dalvador2/nixie_clock/pcb/nixie_clock/in-14-nixie-tube-1.snapshot.4/NX-SZP-IN14/Render/Render_white_1.JPG

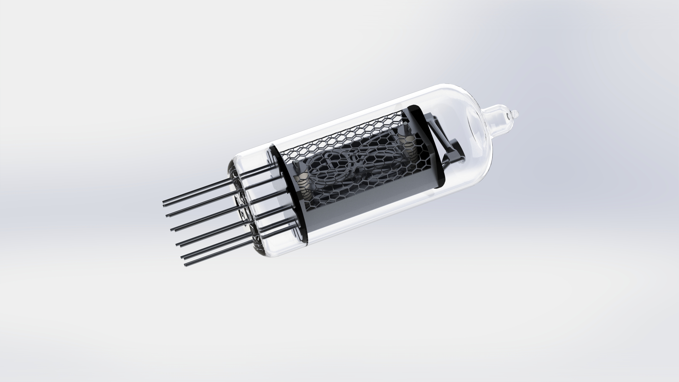
pcb/nixie_clock/in-14-nixie-tube-1.snapshot.4/NX-SZP-IN14/Render/Render_white_1.JPG
