dalvador2/nixie_clock/pcb/nixie_clock/in-14-nixie-tube-1.snapshot.4/NX-SZP-IN14/NX-SZP-IN14-v01.SLDASM

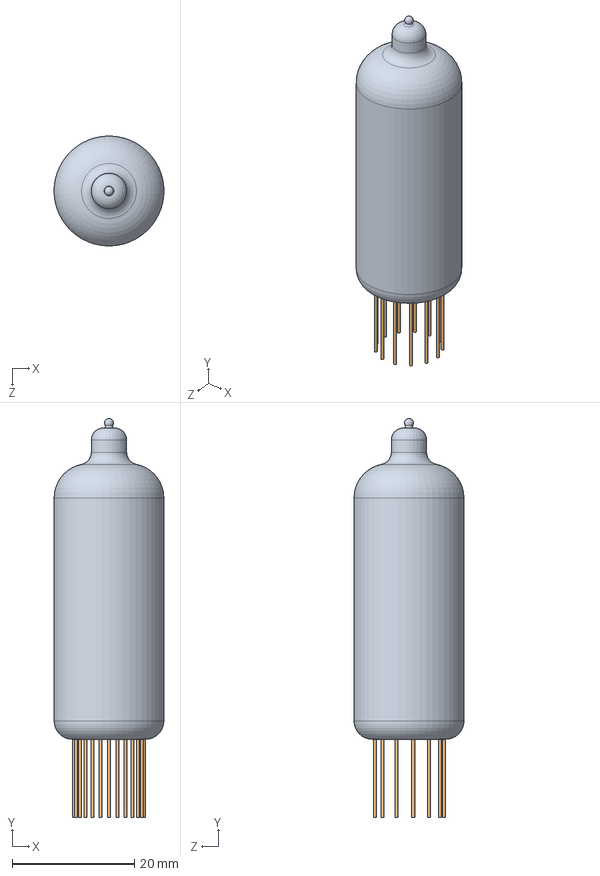
[picture p6: CAD file, 2024-11-07]
pcb/nixie_clock/in-14-nixie-tube-1.snapshot.4/NX-SZP-IN14/NX-SZP-IN14-v01.SLDASM
18.0 x 65.3 x 18.0 mm
NX-SZP-IN14-10-v01
NX-SZP-IN14-11-v01 x 13
NX-SZP-IN14-12-v01
NX-SZP-IN14-13-v01
NX-SZP-IN14-14-v01
NX-SZP-IN14-15-v01
NX-SZP-IN14-16-v01
NX-SZP-IN14-17-v01
NX-SZP-IN14-18-v01 x 2
NX-SZP-IN14-00-v01
NX-SZP-IN14-01-v01
NX-SZP-IN14-02-v01
NX-SZP-IN14-03-v01
NX-SZP-IN14-04-v01
NX-SZP-IN14-05-v01
NX-SZP-IN14-06-v01
NX-SZP-IN14-07-v01
NX-SZP-IN14-08-v01
NX-SZP-IN14-09-v01
NX-SZP-IN14-19-v01
NX-SZP-IN14-20-v01
NX-SZP-IN14-21-v01
NX-SZP-IN14-21-v02
