dalvador2/nixie_clock/pcb/nixie_clock/in-14-nixie-tube-1.snapshot.4/NX-SZP-IN14/NX-SZP-IN14-03-v01.SLDPRT

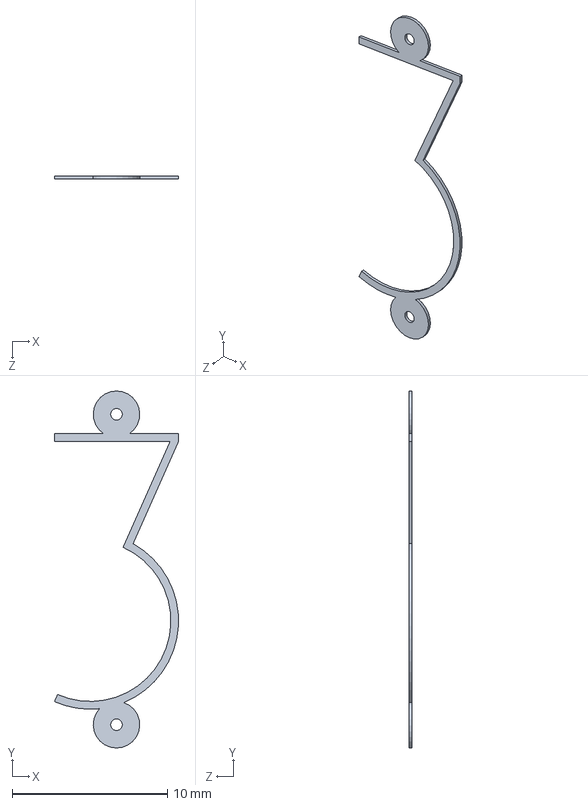
[picture p10: CAD file, 2024-11-07]
pcb/nixie_clock/in-14-nixie-tube-1.snapshot.4/NX-SZP-IN14/NX-SZP-IN14-03-v01.SLDPRT
8.00 x 23.0 x 0.2 mm
