dalvador2/nixie_clock/(list of files, cad)

Other CAD files:
pcb/nixie_clock/in-14-nixie-tube-1.snapshot.4/NX-SZP-IN14/NX-SZP-IN14-06-v01.SLDPRT
pcb/nixie_clock/in-14-nixie-tube-1.snapshot.4/NX-SZP-IN14/NX-SZP-IN14-21-v01.SLDPRT
