dalvador2/nixie_clock/pcb/nixie_clock/nixie_clock.kicad_pcb

## KiCad design pcb/nixie_clock/nixie_clock.kicad_pcb (2025-03-24)

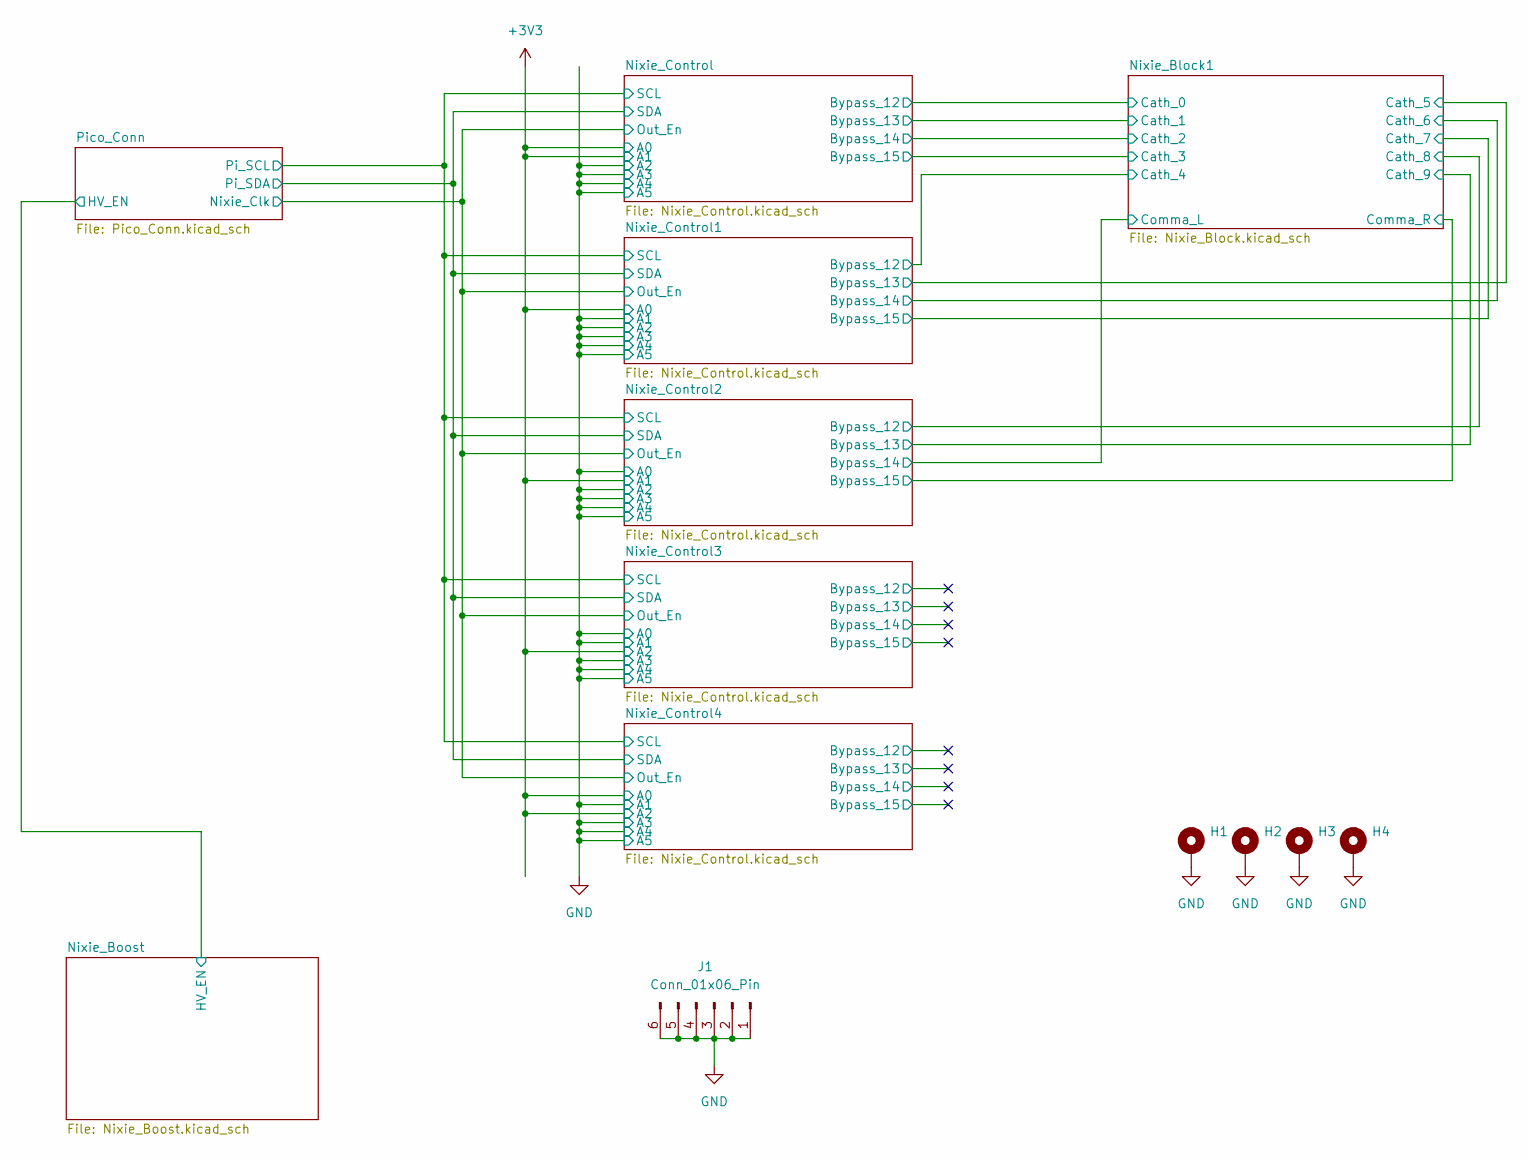
[picture p28: schematic nixie_clock.kicad_sch]

Parts:
H1, H2, H3, H4: MountingHole_Pad; MountingHole_2.7mm_M2.5_DIN965_Pad
J1: Conn_01x06_Pin; Molex_KK-254_AE-6410-06A_1x06_P2.54mm_Vertical

Connections:
GND: H1.1, H2.1, H3.1, H4.1, J1.1, J1.2, J1.3, J1.4, J1.5, J1.6; also elsewhere on the board

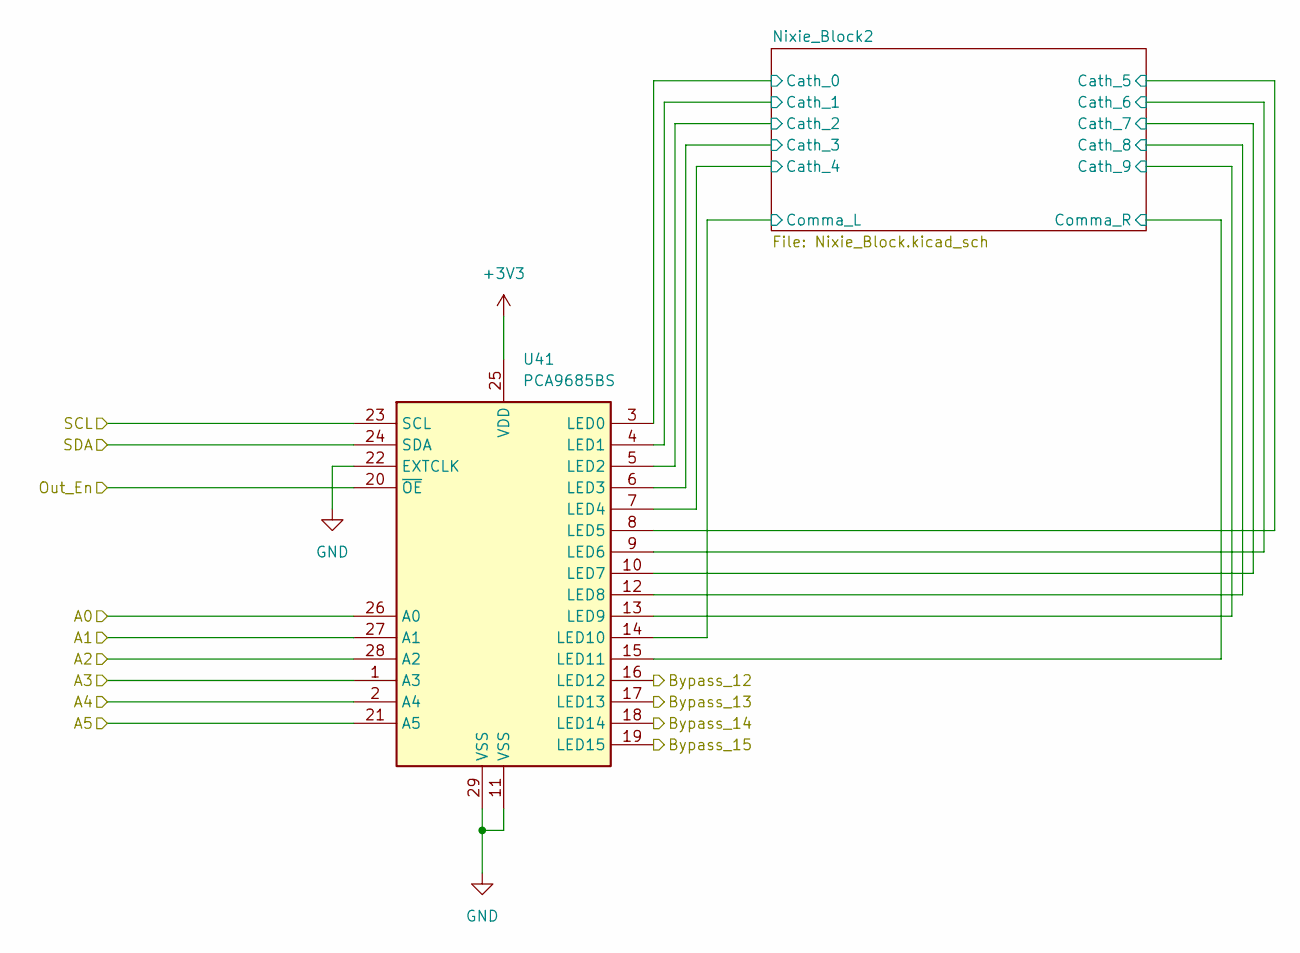
[picture p29: schematic Nixie_Control.kicad_sch]

Parts:
U41: PCA9685BS; QFN-28-1EP_6x6mm_P0.65mm_EP4.25x4.25mm; LCSC Part # C5191634

Connections:
+3V3: U41.25 (VDD), U41.28 (A2); also elsewhere on the board
/Nixie_Control3/Bypass_12: U41.16 (LED12)
/Nixie_Control3/Bypass_13: U41.17 (LED13)
/Nixie_Control3/Bypass_14: U41.18 (LED14)
/Nixie_Control3/Bypass_15: U41.19 (LED15)
/Nixie_Control3/Nixie_Block2/Cath_0: U41.3 (LED0); also elsewhere on the board
/Nixie_Control3/Nixie_Block2/Cath_1: U41.4 (LED1); also elsewhere on the board
/Nixie_Control3/Nixie_Block2/Cath_2: U41.5 (LED2); also elsewhere on the board
/Nixie_Control3/Nixie_Block2/Cath_3: U41.6 (LED3); also elsewhere on the board
/Nixie_Control3/Nixie_Block2/Cath_4: U41.7 (LED4); also elsewhere on the board
/Nixie_Control3/Nixie_Block2/Cath_5: U41.8 (LED5); also elsewhere on the board
/Nixie_Control3/Nixie_Block2/Cath_6: U41.9 (LED6); also elsewhere on the board
/Nixie_Control3/Nixie_Block2/Cath_7: U41.10 (LED7); also elsewhere on the board
/Nixie_Control3/Nixie_Block2/Cath_8: U41.12 (LED8); also elsewhere on the board
/Nixie_Control3/Nixie_Block2/Cath_9: U41.13 (LED9); also elsewhere on the board
/Nixie_Control3/Nixie_Block2/Comma_L: U41.14 (LED10); also elsewhere on the board
/Nixie_Control3/Nixie_Block2/Comma_R: U41.15 (LED11); also elsewhere on the board
/Nixie_Control/Out_En: U41.20 (~OE); also elsewhere on the board
/Nixie_Control/SCL: U41.23 (SCL); also elsewhere on the board
/Nixie_Control/SDA: U41.24 (SDA); also elsewhere on the board
GND: U41.1 (A3), U41.2 (A4), U41.11 (VSS), U41.21 (A5), U41.22 (EXTCLK), U41.26 (A0), U41.27 (A1), U41.29 (VSS); also elsewhere on the board

Parts of its further copies:
U13, U15, U28, U54: PCA9685BS; QFN-28-1EP_6x6mm_P0.65mm_EP4.25x4.25mm; LCSC Part # C5191634

Connections of its further copies:
+3V3: U13.25 (VDD), U13.26 (A0), U13.27 (A1), U15.25 (VDD), U15.26 (A0), U28.25 (VDD), U28.27 (A1), U54.25 (VDD), U54.26 (A0), U54.28 (A2); also elsewhere on the board
/Nixie_Block1/Cath_0: U13.16 (LED12); also elsewhere on the board
/Nixie_Block1/Cath_1: U13.17 (LED13); also elsewhere on the board
/Nixie_Block1/Cath_2: U13.18 (LED14); also elsewhere on the board
/Nixie_Block1/Cath_3: U13.19 (LED15); also elsewhere on the board
/Nixie_Block1/Cath_4: U15.16 (LED12); also elsewhere on the board
/Nixie_Block1/Cath_5: U15.17 (LED13); also elsewhere on the board
/Nixie_Block1/Cath_6: U15.18 (LED14); also elsewhere on the board
/Nixie_Block1/Cath_7: U15.19 (LED15); also elsewhere on the board
/Nixie_Block1/Cath_8: U28.16 (LED12); also elsewhere on the board
/Nixie_Block1/Cath_9: U28.17 (LED13); also elsewhere on the board
/Nixie_Block1/Comma_L: U28.18 (LED14); also elsewhere on the board
/Nixie_Block1/Comma_R: U28.19 (LED15); also elsewhere on the board
/Nixie_Control1/Nixie_Block2/Cath_0: U15.3 (LED0); also elsewhere on the board
/Nixie_Control1/Nixie_Block2/Cath_1: U15.4 (LED1); also elsewhere on the board
/Nixie_Control1/Nixie_Block2/Cath_2: U15.5 (LED2); also elsewhere on the board
/Nixie_Control1/Nixie_Block2/Cath_3: U15.6 (LED3); also elsewhere on the board
/Nixie_Control1/Nixie_Block2/Cath_4: U15.7 (LED4); also elsewhere on the board
/Nixie_Control1/Nixie_Block2/Cath_5: U15.8 (LED5); also elsewhere on the board
/Nixie_Control1/Nixie_Block2/Cath_6: U15.9 (LED6); also elsewhere on the board
/Nixie_Control1/Nixie_Block2/Cath_7: U15.10 (LED7); also elsewhere on the board
/Nixie_Control1/Nixie_Block2/Cath_8: U15.12 (LED8); also elsewhere on the board
/Nixie_Control1/Nixie_Block2/Cath_9: U15.13 (LED9); also elsewhere on the board
/Nixie_Control1/Nixie_Block2/Comma_L: U15.14 (LED10); also elsewhere on the board
/Nixie_Control1/Nixie_Block2/Comma_R: U15.15 (LED11); also elsewhere on the board
/Nixie_Control2/Nixie_Block2/Cath_0: U28.3 (LED0); also elsewhere on the board
/Nixie_Control2/Nixie_Block2/Cath_1: U28.4 (LED1); also elsewhere on the board
/Nixie_Control2/Nixie_Block2/Cath_2: U28.5 (LED2); also elsewhere on the board
/Nixie_Control2/Nixie_Block2/Cath_3: U28.6 (LED3); also elsewhere on the board
/Nixie_Control2/Nixie_Block2/Cath_4: U28.7 (LED4); also elsewhere on the board
/Nixie_Control2/Nixie_Block2/Cath_5: U28.8 (LED5); also elsewhere on the board
/Nixie_Control2/Nixie_Block2/Cath_6: U28.9 (LED6); also elsewhere on the board
/Nixie_Control2/Nixie_Block2/Cath_7: U28.10 (LED7); also elsewhere on the board
/Nixie_Control2/Nixie_Block2/Cath_8: U28.12 (LED8); also elsewhere on the board
/Nixie_Control2/Nixie_Block2/Cath_9: U28.13 (LED9); also elsewhere on the board
/Nixie_Control2/Nixie_Block2/Comma_L: U28.14 (LED10); also elsewhere on the board
/Nixie_Control2/Nixie_Block2/Comma_R: U28.15 (LED11); also elsewhere on the board
/Nixie_Control4/Bypass_12: U54.16 (LED12)
/Nixie_Control4/Bypass_13: U54.17 (LED13)
/Nixie_Control4/Bypass_14: U54.18 (LED14)
/Nixie_Control4/Bypass_15: U54.19 (LED15)
/Nixie_Control4/Nixie_Block2/Cath_0: U54.3 (LED0); also elsewhere on the board
/Nixie_Control4/Nixie_Block2/Cath_1: U54.4 (LED1); also elsewhere on the board
/Nixie_Control4/Nixie_Block2/Cath_2: U54.5 (LED2); also elsewhere on the board
/Nixie_Control4/Nixie_Block2/Cath_3: U54.6 (LED3); also elsewhere on the board
/Nixie_Control4/Nixie_Block2/Cath_4: U54.7 (LED4); also elsewhere on the board
/Nixie_Control4/Nixie_Block2/Cath_5: U54.8 (LED5); also elsewhere on the board
/Nixie_Control4/Nixie_Block2/Cath_6: U54.9 (LED6); also elsewhere on the board
/Nixie_Control4/Nixie_Block2/Cath_7: U54.10 (LED7); also elsewhere on the board
/Nixie_Control4/Nixie_Block2/Cath_8: U54.12 (LED8); also elsewhere on the board
/Nixie_Control4/Nixie_Block2/Cath_9: U54.13 (LED9); also elsewhere on the board
/Nixie_Control4/Nixie_Block2/Comma_L: U54.14 (LED10); also elsewhere on the board
/Nixie_Control4/Nixie_Block2/Comma_R: U54.15 (LED11); also elsewhere on the board
/Nixie_Control/Nixie_Block2/Cath_0: U13.3 (LED0); also elsewhere on the board
/Nixie_Control/Nixie_Block2/Cath_1: U13.4 (LED1); also elsewhere on the board
/Nixie_Control/Nixie_Block2/Cath_2: U13.5 (LED2); also elsewhere on the board
/Nixie_Control/Nixie_Block2/Cath_3: U13.6 (LED3); also elsewhere on the board
/Nixie_Control/Nixie_Block2/Cath_4: U13.7 (LED4); also elsewhere on the board
/Nixie_Control/Nixie_Block2/Cath_5: U13.8 (LED5); also elsewhere on the board
/Nixie_Control/Nixie_Block2/Cath_6: U13.9 (LED6); also elsewhere on the board
/Nixie_Control/Nixie_Block2/Cath_7: U13.10 (LED7); also elsewhere on the board
/Nixie_Control/Nixie_Block2/Cath_8: U13.12 (LED8); also elsewhere on the board
/Nixie_Control/Nixie_Block2/Cath_9: U13.13 (LED9); also elsewhere on the board
/Nixie_Control/Nixie_Block2/Comma_L: U13.14 (LED10); also elsewhere on the board
/Nixie_Control/Nixie_Block2/Comma_R: U13.15 (LED11); also elsewhere on the board
/Nixie_Control/Out_En: U13.20 (~OE), U15.20 (~OE), U28.20 (~OE), U54.20 (~OE); also elsewhere on the board
/Nixie_Control/SCL: U13.23 (SCL), U15.23 (SCL), U28.23 (SCL), U54.23 (SCL); also elsewhere on the board
/Nixie_Control/SDA: U13.24 (SDA), U15.24 (SDA), U28.24 (SDA), U54.24 (SDA); also elsewhere on the board
GND: U13.1 (A3), U13.2 (A4), U13.11 (VSS), U13.21 (A5), U13.22 (EXTCLK), U13.28 (A2), U13.29 (VSS), U15.1 (A3), U15.2 (A4), U15.11 (VSS), U15.21 (A5), U15.22 (EXTCLK), U15.27 (A1), U15.28 (A2), U15.29 (VSS), U28.1 (A3), U28.2 (A4), U28.11 (VSS), U28.21 (A5), U28.22 (EXTCLK), U28.26 (A0), U28.28 (A2), U28.29 (VSS), U54.1 (A3), U54.2 (A4), U54.11 (VSS), U54.21 (A5), U54.22 (EXTCLK), U54.27 (A1), U54.29 (VSS); also elsewhere on the board

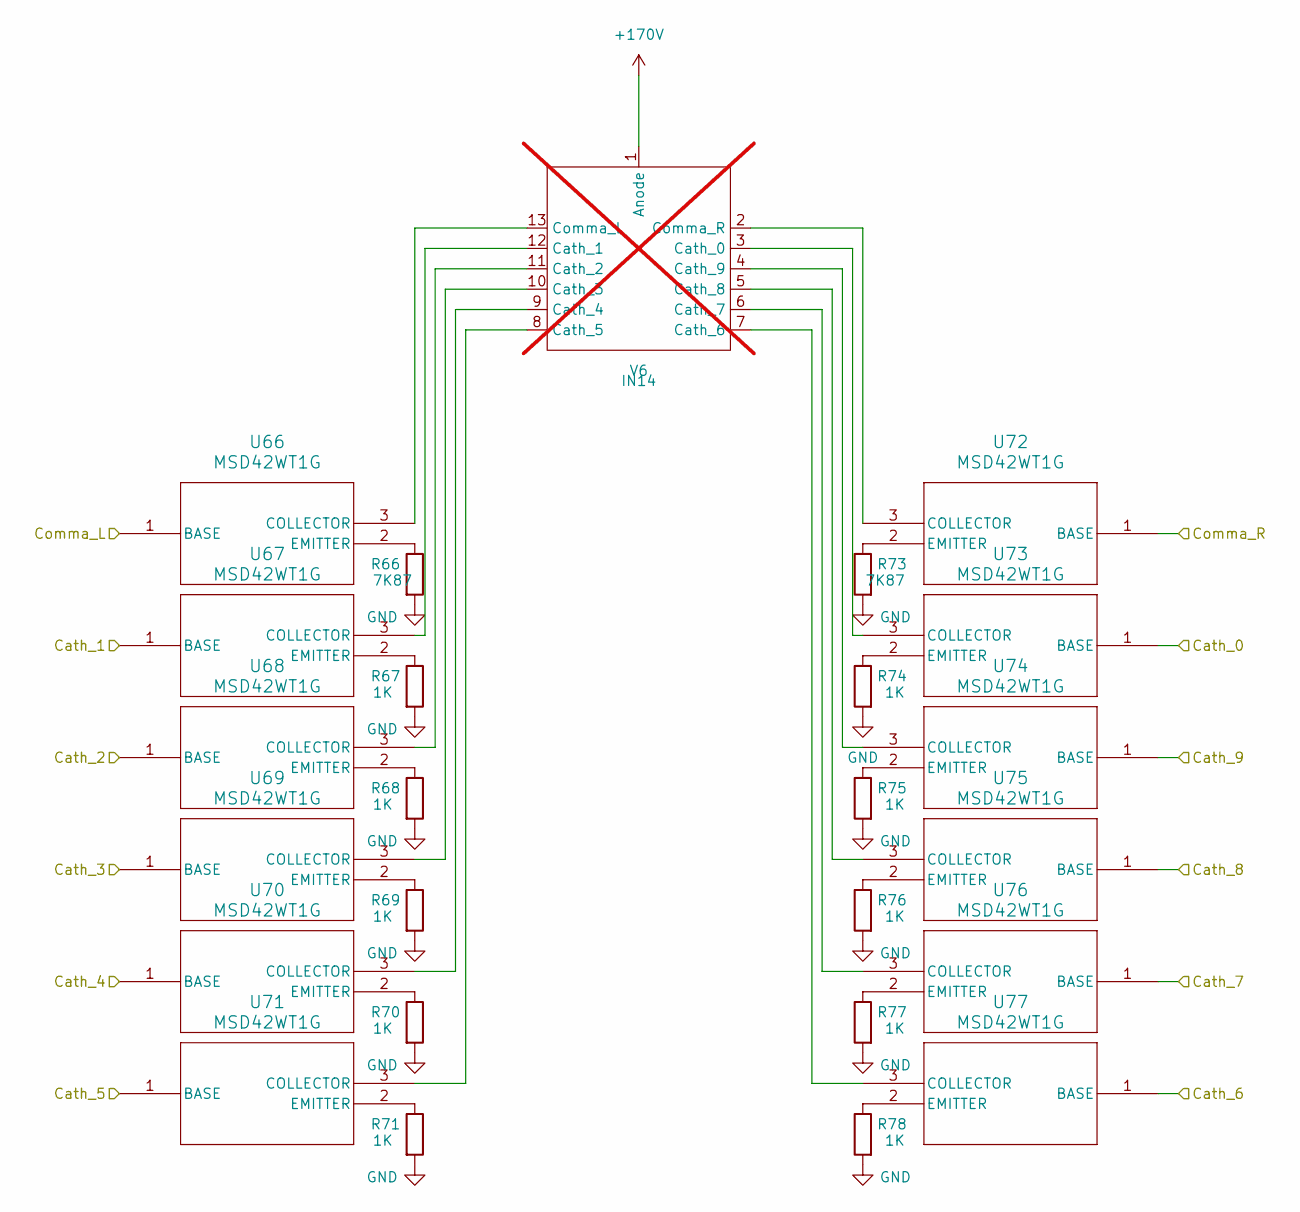
[picture p30: schematic Nixie_Block.kicad_sch]

Parts:
R66, R73: 7K87; R_0603_1608Metric; LCSC Part # C137680
R67, R68, R69, R70, R71, R74, R75, R76, R77, R78: 1K; R_0603_1608Metric; LCSC Part # C22548
U66, U67, U68, U69, U70, U71, U72, U73, U74, U75, U76, U77: MSD42WT1G; SOT-323-3_2P2X1P35_ONS; LCSC Part # C891781
V6: IN14; not fitted

Connections:
+170V: V6.1 (Anode); also elsewhere on the board
/Nixie_Block1/Cath_0: U67.1 (BASE); also elsewhere on the board
/Nixie_Block1/Cath_1: U73.1 (BASE); also elsewhere on the board
/Nixie_Block1/Cath_2: U74.1 (BASE); also elsewhere on the board
/Nixie_Block1/Cath_3: U75.1 (BASE); also elsewhere on the board
/Nixie_Block1/Cath_4: U76.1 (BASE); also elsewhere on the board
/Nixie_Block1/Cath_5: U77.1 (BASE); also elsewhere on the board
/Nixie_Block1/Cath_6: U71.1 (BASE); also elsewhere on the board
/Nixie_Block1/Cath_7: U70.1 (BASE); also elsewhere on the board
/Nixie_Block1/Cath_8: U69.1 (BASE); also elsewhere on the board
/Nixie_Block1/Cath_9: U68.1 (BASE); also elsewhere on the board
/Nixie_Block1/Comma_L: U72.1 (BASE); also elsewhere on the board
/Nixie_Block1/Comma_R: U66.1 (BASE); also elsewhere on the board
GND: R66.2, R67.2, R68.2, R69.2, R70.2, R71.2, R73.2, R74.2, R75.2, R76.2, R77.2, R78.2; also elsewhere on the board
unnamed: U66.3 (COLLECTOR), V6.13 (Comma_R)
unnamed: R66.1, U66.2 (EMITTER)
unnamed: U67.3 (COLLECTOR), V6.12 (Cath_0)
unnamed: R67.1, U67.2 (EMITTER)
unnamed: U68.3 (COLLECTOR), V6.11 (Cath_9)
unnamed: R68.1, U68.2 (EMITTER)
unnamed: U69.3 (COLLECTOR), V6.10 (Cath_8)
unnamed: R69.1, U69.2 (EMITTER)
unnamed: U70.3 (COLLECTOR), V6.9 (Cath_7)
unnamed: R70.1, U70.2 (EMITTER)
unnamed: U71.3 (COLLECTOR), V6.8 (Cath_6)
unnamed: R71.1, U71.2 (EMITTER)
unnamed: U72.3 (COLLECTOR), V6.2 (Comma_L)
unnamed: R73.1, U72.2 (EMITTER)
unnamed: U73.3 (COLLECTOR), V6.3 (Cath_1)
unnamed: R74.1, U73.2 (EMITTER)
unnamed: U74.3 (COLLECTOR), V6.4 (Cath_2)
unnamed: R75.1, U74.2 (EMITTER)
unnamed: U75.3 (COLLECTOR), V6.5 (Cath_3)
unnamed: R76.1, U75.2 (EMITTER)
unnamed: U76.3 (COLLECTOR), V6.6 (Cath_4)
unnamed: R77.1, U76.2 (EMITTER)
unnamed: U77.3 (COLLECTOR), V6.7 (Cath_5)
unnamed: R78.1, U77.2 (EMITTER)

Parts of its further copies:
R1, R7, R13, R19, R25, R31, R37, R43, R49, R55: 7K87; R_0603_1608Metric; LCSC Part # C137680
R2, R3, R4, R5, R6, R8, R9, R10, R11, R12, R14, R15, R16, R17, R18, R20, R21, R22, R23, R24, R26, R27, R28, R29, R30, R32, R33, R34, R35, R36, R38, R39, R40, R41, R42, R44, R45, R46, R47, R48, R50, R51, R52, R53, R54, R56, R57, R58, R59, R60: 1K; R_0603_1608Metric; LCSC Part # C22548
U1, U2, U3, U4, U5, U6, U7, U8, U9, U10, U11, U12, U16, U17, U18, U19, U20, U21, U22, U23, U24, U25, U26, U27, U29, U30, U31, U32, U33, U34, U35, U36, U37, U38, U39, U40, U42, U43, U44, U45, U46, U47, U48, U49, U50, U51, U52, U53, U55, U56, U57, U58, U59, U60, U61, U62, U63, U64, U65, U78: MSD42WT1G; SOT-323-3_2P2X1P35_ONS; LCSC Part # C891781
V1, V2, V3, V4, V5: IN14; not fitted

Connections of its further copies:
+170V: V1.1 (Anode), V2.1 (Anode), V3.1 (Anode), V4.1 (Anode), V5.1 (Anode); also elsewhere on the board
/Nixie_Control1/Nixie_Block2/Cath_0: U17.1 (BASE); also elsewhere on the board
/Nixie_Control1/Nixie_Block2/Cath_1: U23.1 (BASE); also elsewhere on the board
/Nixie_Control1/Nixie_Block2/Cath_2: U24.1 (BASE); also elsewhere on the board
/Nixie_Control1/Nixie_Block2/Cath_3: U25.1 (BASE); also elsewhere on the board
/Nixie_Control1/Nixie_Block2/Cath_4: U26.1 (BASE); also elsewhere on the board
/Nixie_Control1/Nixie_Block2/Cath_5: U27.1 (BASE); also elsewhere on the board
/Nixie_Control1/Nixie_Block2/Cath_6: U21.1 (BASE); also elsewhere on the board
/Nixie_Control1/Nixie_Block2/Cath_7: U20.1 (BASE); also elsewhere on the board
/Nixie_Control1/Nixie_Block2/Cath_8: U19.1 (BASE); also elsewhere on the board
/Nixie_Control1/Nixie_Block2/Cath_9: U18.1 (BASE); also elsewhere on the board
/Nixie_Control1/Nixie_Block2/Comma_L: U22.1 (BASE); also elsewhere on the board
/Nixie_Control1/Nixie_Block2/Comma_R: U16.1 (BASE); also elsewhere on the board
/Nixie_Control2/Nixie_Block2/Cath_0: U30.1 (BASE); also elsewhere on the board
/Nixie_Control2/Nixie_Block2/Cath_1: U36.1 (BASE); also elsewhere on the board
/Nixie_Control2/Nixie_Block2/Cath_2: U37.1 (BASE); also elsewhere on the board
/Nixie_Control2/Nixie_Block2/Cath_3: U38.1 (BASE); also elsewhere on the board
/Nixie_Control2/Nixie_Block2/Cath_4: U39.1 (BASE); also elsewhere on the board
/Nixie_Control2/Nixie_Block2/Cath_5: U40.1 (BASE); also elsewhere on the board
/Nixie_Control2/Nixie_Block2/Cath_6: U34.1 (BASE); also elsewhere on the board
/Nixie_Control2/Nixie_Block2/Cath_7: U33.1 (BASE); also elsewhere on the board
/Nixie_Control2/Nixie_Block2/Cath_8: U32.1 (BASE); also elsewhere on the board
/Nixie_Control2/Nixie_Block2/Cath_9: U31.1 (BASE); also elsewhere on the board
/Nixie_Control2/Nixie_Block2/Comma_L: U35.1 (BASE); also elsewhere on the board
/Nixie_Control2/Nixie_Block2/Comma_R: U29.1 (BASE); also elsewhere on the board
/Nixie_Control3/Nixie_Block2/Cath_0: U43.1 (BASE); also elsewhere on the board
/Nixie_Control3/Nixie_Block2/Cath_1: U49.1 (BASE); also elsewhere on the board
/Nixie_Control3/Nixie_Block2/Cath_2: U50.1 (BASE); also elsewhere on the board
/Nixie_Control3/Nixie_Block2/Cath_3: U51.1 (BASE); also elsewhere on the board
/Nixie_Control3/Nixie_Block2/Cath_4: U52.1 (BASE); also elsewhere on the board
/Nixie_Control3/Nixie_Block2/Cath_5: U53.1 (BASE); also elsewhere on the board
/Nixie_Control3/Nixie_Block2/Cath_6: U47.1 (BASE); also elsewhere on the board
/Nixie_Control3/Nixie_Block2/Cath_7: U46.1 (BASE); also elsewhere on the board
/Nixie_Control3/Nixie_Block2/Cath_8: U45.1 (BASE); also elsewhere on the board
/Nixie_Control3/Nixie_Block2/Cath_9: U44.1 (BASE); also elsewhere on the board
/Nixie_Control3/Nixie_Block2/Comma_L: U48.1 (BASE); also elsewhere on the board
/Nixie_Control3/Nixie_Block2/Comma_R: U42.1 (BASE); also elsewhere on the board
/Nixie_Control4/Nixie_Block2/Cath_0: U56.1 (BASE); also elsewhere on the board
/Nixie_Control4/Nixie_Block2/Cath_1: U62.1 (BASE); also elsewhere on the board
/Nixie_Control4/Nixie_Block2/Cath_2: U63.1 (BASE); also elsewhere on the board
/Nixie_Control4/Nixie_Block2/Cath_3: U64.1 (BASE); also elsewhere on the board
/Nixie_Control4/Nixie_Block2/Cath_4: U65.1 (BASE); also elsewhere on the board
/Nixie_Control4/Nixie_Block2/Cath_5: U78.1 (BASE); also elsewhere on the board
/Nixie_Control4/Nixie_Block2/Cath_6: U60.1 (BASE); also elsewhere on the board
/Nixie_Control4/Nixie_Block2/Cath_7: U59.1 (BASE); also elsewhere on the board
/Nixie_Control4/Nixie_Block2/Cath_8: U58.1 (BASE); also elsewhere on the board
/Nixie_Control4/Nixie_Block2/Cath_9: U57.1 (BASE); also elsewhere on the board
/Nixie_Control4/Nixie_Block2/Comma_L: U61.1 (BASE); also elsewhere on the board
/Nixie_Control4/Nixie_Block2/Comma_R: U55.1 (BASE); also elsewhere on the board
/Nixie_Control/Nixie_Block2/Cath_0: U2.1 (BASE); also elsewhere on the board
/Nixie_Control/Nixie_Block2/Cath_1: U8.1 (BASE); also elsewhere on the board
/Nixie_Control/Nixie_Block2/Cath_2: U9.1 (BASE); also elsewhere on the board
/Nixie_Control/Nixie_Block2/Cath_3: U10.1 (BASE); also elsewhere on the board
/Nixie_Control/Nixie_Block2/Cath_4: U11.1 (BASE); also elsewhere on the board
/Nixie_Control/Nixie_Block2/Cath_5: U12.1 (BASE); also elsewhere on the board
/Nixie_Control/Nixie_Block2/Cath_6: U6.1 (BASE); also elsewhere on the board
/Nixie_Control/Nixie_Block2/Cath_7: U5.1 (BASE); also elsewhere on the board
/Nixie_Control/Nixie_Block2/Cath_8: U4.1 (BASE); also elsewhere on the board
/Nixie_Control/Nixie_Block2/Cath_9: U3.1 (BASE); also elsewhere on the board
/Nixie_Control/Nixie_Block2/Comma_L: U7.1 (BASE); also elsewhere on the board
/Nixie_Control/Nixie_Block2/Comma_R: U1.1 (BASE); also elsewhere on the board
GND: R1.2, R2.2, R3.2, R4.2, R5.2, R6.2, R7.2, R8.2, R9.2, R10.2, R11.2, R12.2, R13.2, R14.2, R15.2, R16.2, R17.2, R18.2, R19.2, R20.2, R21.2, R22.2, R23.2, R24.2, R25.2, R26.2, R27.2, R28.2, R29.2, R30.2, R31.2, R32.2, R33.2, R34.2, R35.2, R36.2, R37.2, R38.2, R39.2, R40.2, R41.2, R42.2, R43.2, R44.2, R45.2, R46.2, R47.2, R48.2, R49.2, R50.2, R51.2, R52.2, R53.2, R54.2, R55.2, R56.2, R57.2, R58.2, R59.2, R60.2; also elsewhere on the board
unnamed: U1.3 (COLLECTOR), V1.13 (Comma_R)
unnamed: R1.1, U1.2 (EMITTER)
unnamed: U2.3 (COLLECTOR), V1.12 (Cath_0)
unnamed: R2.1, U2.2 (EMITTER)
unnamed: U3.3 (COLLECTOR), V1.11 (Cath_9)
unnamed: R3.1, U3.2 (EMITTER)
unnamed: U4.3 (COLLECTOR), V1.10 (Cath_8)
unnamed: R4.1, U4.2 (EMITTER)
unnamed: U5.3 (COLLECTOR), V1.9 (Cath_7)
unnamed: R5.1, U5.2 (EMITTER)
unnamed: U6.3 (COLLECTOR), V1.8 (Cath_6)
unnamed: R6.1, U6.2 (EMITTER)
unnamed: U7.3 (COLLECTOR), V1.2 (Comma_L)
unnamed: R7.1, U7.2 (EMITTER)
unnamed: U8.3 (COLLECTOR), V1.3 (Cath_1)
unnamed: R8.1, U8.2 (EMITTER)
unnamed: U9.3 (COLLECTOR), V1.4 (Cath_2)
unnamed: R9.1, U9.2 (EMITTER)
unnamed: U10.3 (COLLECTOR), V1.5 (Cath_3)
unnamed: R10.1, U10.2 (EMITTER)
unnamed: U11.3 (COLLECTOR), V1.6 (Cath_4)
unnamed: R11.1, U11.2 (EMITTER)
unnamed: U12.3 (COLLECTOR), V1.7 (Cath_5)
unnamed: R12.1, U12.2 (EMITTER)
unnamed: U16.3 (COLLECTOR), V2.13 (Comma_R)
unnamed: R13.1, U16.2 (EMITTER)
unnamed: U17.3 (COLLECTOR), V2.12 (Cath_0)
unnamed: R14.1, U17.2 (EMITTER)
unnamed: U18.3 (COLLECTOR), V2.11 (Cath_9)
unnamed: R15.1, U18.2 (EMITTER)
unnamed: U19.3 (COLLECTOR), V2.10 (Cath_8)
unnamed: R16.1, U19.2 (EMITTER)
unnamed: U20.3 (COLLECTOR), V2.9 (Cath_7)
unnamed: R17.1, U20.2 (EMITTER)
unnamed: U21.3 (COLLECTOR), V2.8 (Cath_6)
unnamed: R18.1, U21.2 (EMITTER)
unnamed: U22.3 (COLLECTOR), V2.2 (Comma_L)
unnamed: R19.1, U22.2 (EMITTER)
unnamed: U23.3 (COLLECTOR), V2.3 (Cath_1)
unnamed: R20.1, U23.2 (EMITTER)
unnamed: U24.3 (COLLECTOR), V2.4 (Cath_2)
unnamed: R21.1, U24.2 (EMITTER)
unnamed: U25.3 (COLLECTOR), V2.5 (Cath_3)
unnamed: R22.1, U25.2 (EMITTER)
unnamed: U26.3 (COLLECTOR), V2.6 (Cath_4)
unnamed: R23.1, U26.2 (EMITTER)
unnamed: U27.3 (COLLECTOR), V2.7 (Cath_5)
unnamed: R24.1, U27.2 (EMITTER)
unnamed: U29.3 (COLLECTOR), V3.13 (Comma_R)
unnamed: R25.1, U29.2 (EMITTER)
unnamed: U30.3 (COLLECTOR), V3.12 (Cath_0)
unnamed: R26.1, U30.2 (EMITTER)
unnamed: U31.3 (COLLECTOR), V3.11 (Cath_9)
unnamed: R27.1, U31.2 (EMITTER)
unnamed: U32.3 (COLLECTOR), V3.10 (Cath_8)
unnamed: R28.1, U32.2 (EMITTER)
unnamed: U33.3 (COLLECTOR), V3.9 (Cath_7)
unnamed: R29.1, U33.2 (EMITTER)
unnamed: U34.3 (COLLECTOR), V3.8 (Cath_6)
unnamed: R30.1, U34.2 (EMITTER)
unnamed: U35.3 (COLLECTOR), V3.2 (Comma_L)
unnamed: R31.1, U35.2 (EMITTER)
unnamed: U36.3 (COLLECTOR), V3.3 (Cath_1)
unnamed: R32.1, U36.2 (EMITTER)
unnamed: U37.3 (COLLECTOR), V3.4 (Cath_2)
unnamed: R33.1, U37.2 (EMITTER)
unnamed: U38.3 (COLLECTOR), V3.5 (Cath_3)
unnamed: R34.1, U38.2 (EMITTER)
unnamed: U39.3 (COLLECTOR), V3.6 (Cath_4)
unnamed: R35.1, U39.2 (EMITTER)
unnamed: U40.3 (COLLECTOR), V3.7 (Cath_5)
unnamed: R36.1, U40.2 (EMITTER)
unnamed: U42.3 (COLLECTOR), V4.13 (Comma_R)
unnamed: R37.1, U42.2 (EMITTER)
unnamed: U43.3 (COLLECTOR), V4.12 (Cath_0)
unnamed: R38.1, U43.2 (EMITTER)
unnamed: U44.3 (COLLECTOR), V4.11 (Cath_9)
unnamed: R39.1, U44.2 (EMITTER)
unnamed: U45.3 (COLLECTOR), V4.10 (Cath_8)
unnamed: R40.1, U45.2 (EMITTER)
unnamed: U46.3 (COLLECTOR), V4.9 (Cath_7)
unnamed: R41.1, U46.2 (EMITTER)
unnamed: U47.3 (COLLECTOR), V4.8 (Cath_6)
unnamed: R42.1, U47.2 (EMITTER)
unnamed: U48.3 (COLLECTOR), V4.2 (Comma_L)
unnamed: R43.1, U48.2 (EMITTER)
unnamed: U49.3 (COLLECTOR), V4.3 (Cath_1)
unnamed: R44.1, U49.2 (EMITTER)
unnamed: U50.3 (COLLECTOR), V4.4 (Cath_2)
unnamed: R45.1, U50.2 (EMITTER)
unnamed: U51.3 (COLLECTOR), V4.5 (Cath_3)
unnamed: R46.1, U51.2 (EMITTER)
unnamed: U52.3 (COLLECTOR), V4.6 (Cath_4)
unnamed: R47.1, U52.2 (EMITTER)
unnamed: U53.3 (COLLECTOR), V4.7 (Cath_5)
unnamed: R48.1, U53.2 (EMITTER)
unnamed: U55.3 (COLLECTOR), V5.13 (Comma_R)
unnamed: R49.1, U55.2 (EMITTER)
unnamed: U56.3 (COLLECTOR), V5.12 (Cath_0)
unnamed: R50.1, U56.2 (EMITTER)
unnamed: U57.3 (COLLECTOR), V5.11 (Cath_9)
unnamed: R51.1, U57.2 (EMITTER)
unnamed: U58.3 (COLLECTOR), V5.10 (Cath_8)
unnamed: R52.1, U58.2 (EMITTER)
unnamed: U59.3 (COLLECTOR), V5.9 (Cath_7)
unnamed: R53.1, U59.2 (EMITTER)
unnamed: U60.3 (COLLECTOR), V5.8 (Cath_6)
unnamed: R54.1, U60.2 (EMITTER)
unnamed: U61.3 (COLLECTOR), V5.2 (Comma_L)
unnamed: R55.1, U61.2 (EMITTER)
unnamed: U62.3 (COLLECTOR), V5.3 (Cath_1)
unnamed: R56.1, U62.2 (EMITTER)
unnamed: U63.3 (COLLECTOR), V5.4 (Cath_2)
unnamed: R57.1, U63.2 (EMITTER)
unnamed: U64.3 (COLLECTOR), V5.5 (Cath_3)
unnamed: R58.1, U64.2 (EMITTER)
unnamed: U65.3 (COLLECTOR), V5.6 (Cath_4)
unnamed: R59.1, U65.2 (EMITTER)
unnamed: U78.3 (COLLECTOR), V5.7 (Cath_5)
unnamed: R60.1, U78.2 (EMITTER)

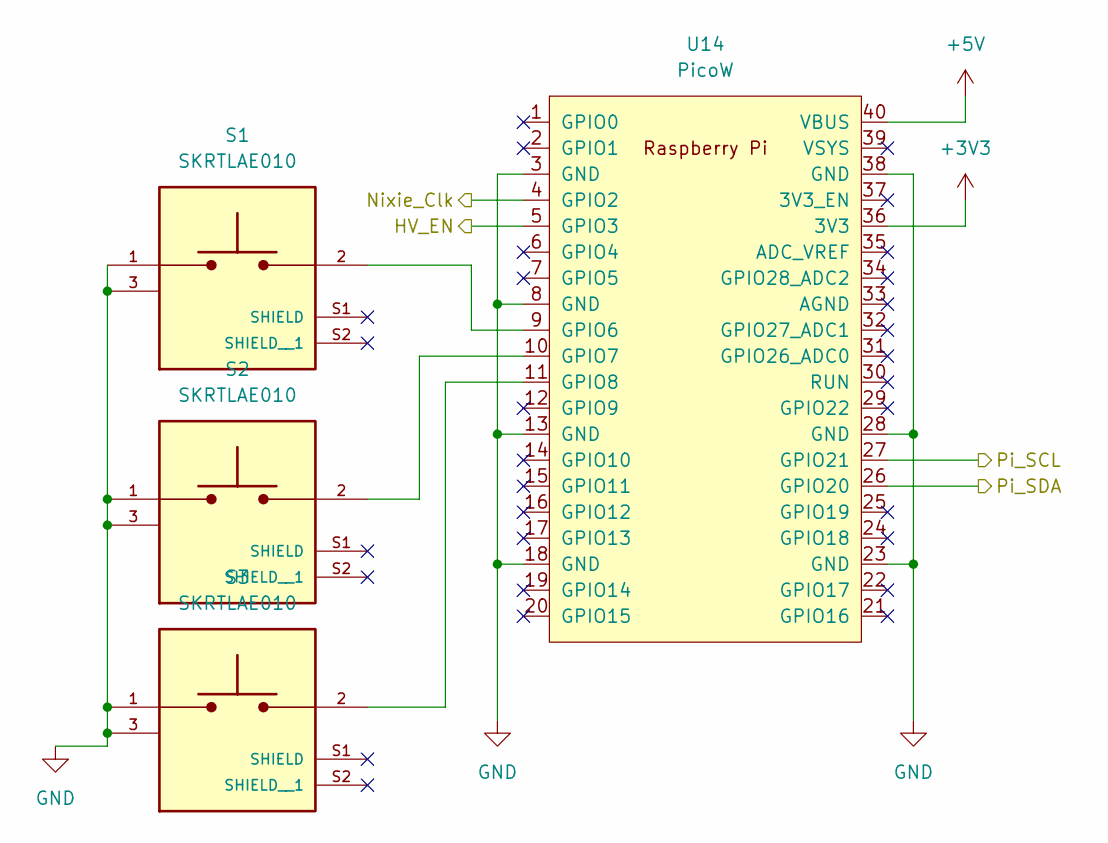
[picture p31: schematic Pico_Conn.kicad_sch]

Parts:
S1, S2, S3: SKRTLAE010; SW_SKRTLAE010; PARTREV --; LCSC Part # C110293
U14: PicoW; RPi_PicoW_SMD; LCSC Part # C7203003

Connections:
+3V3: U14.36 (3V3); also elsewhere on the board
+5V: U14.40 (VBUS); also elsewhere on the board
/Nixie_Boost/HV_EN: U14.5 (GPIO3); also elsewhere on the board
/Nixie_Control/Out_En: U14.4 (GPIO2); also elsewhere on the board
/Nixie_Control/SCL: U14.27 (GPIO21); also elsewhere on the board
/Nixie_Control/SDA: U14.26 (GPIO20); also elsewhere on the board
GND: S1.1, S1.3, S2.1, S2.3, S3.1, S3.3, U14.3 (GND), U14.8 (GND), U14.13 (GND), U14.18 (GND), U14.23 (GND), U14.28 (GND), U14.38 (GND); also elsewhere on the board
unnamed: S1.2, U14.9 (GPIO6)
unnamed: S2.2, U14.10 (GPIO7)
unnamed: S3.2, U14.11 (GPIO8)

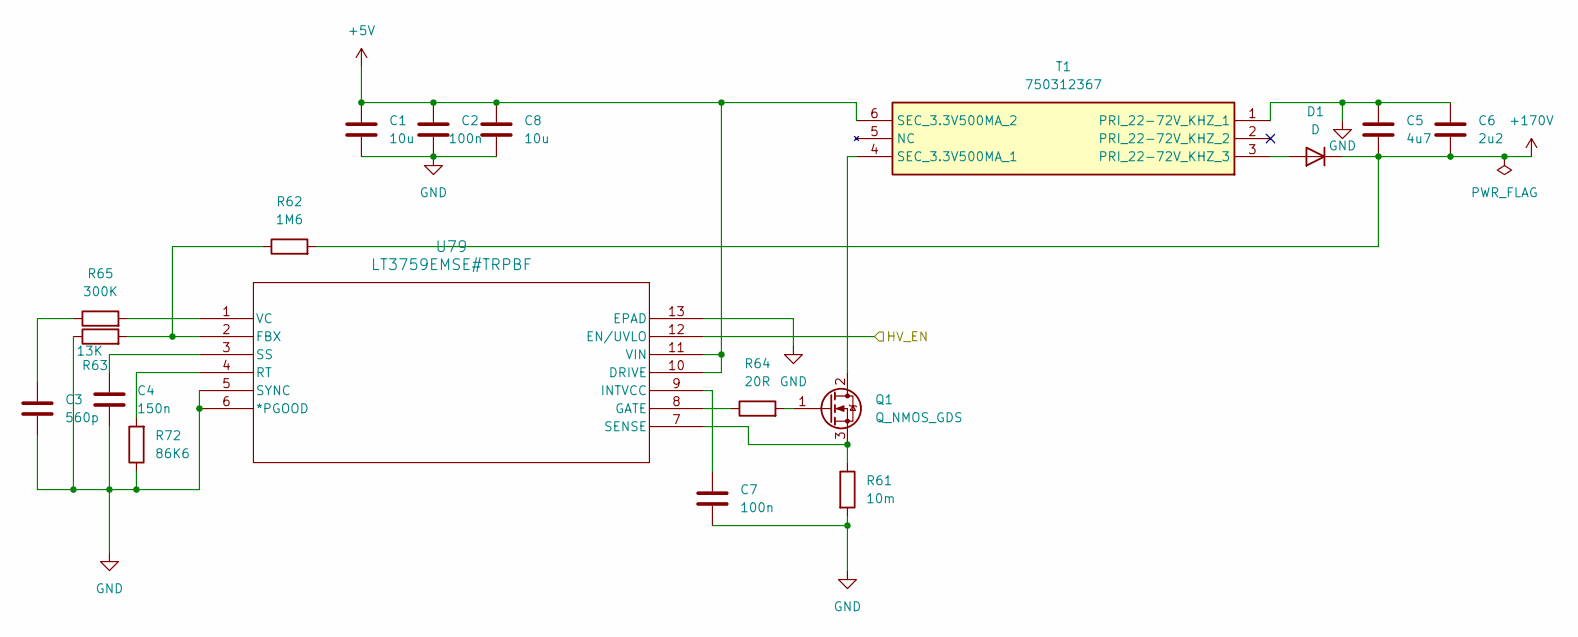
[picture p32: schematic Nixie_Boost.kicad_sch]

Parts:
C1, C8: 10u; C_1210_3225Metric; LCSC Part # C6477141
C2: 100n; C_0805_2012Metric; LCSC Part # C2170365
C3: 560p; C_0603_1608Metric; LCSC Part # C2171678
C4: 150n; C_0603_1608Metric; LCSC Part # C3844381
C5: 4u7; C_0603_1608Metric; LCSC Part # C3842329
C6: 2u2; C_2220_5750Metric; LCSC Part # C2168251
C7: 100n; C_1812_4532Metric; LCSC Part # C2179130
D1: D; D_SOD-123; LCSC Part # C17550678
Q1: Q_NMOS_GDS; LFPAK56; LCSC Part # C3282674
R61: 10m; R_0805_2012Metric; LCSC Part # C2977779
R62: 1M6; R_0603_1608Metric; LCSC Part # C2091296
R63: 13K; R_0603_1608Metric; LCSC Part # C402966
R64: 20R; R_0603_1608Metric; LCSC Part # C400657
R65: 300K; R_0603_1608Metric; LCSC Part # C278615
R72: 86K6; R_0603_1608Metric; LCSC Part # C2094634
T1: 750312367; Mouser Part Number 710-750312367
U79: LT3759EMSE#TRPBF; MSOP-12_MSE_LIT; LCSC Part # C580139

Connections:
+5V: C1.1, C2.1, C8.1, T1.6 (SEC_3.3V500MA_2), U79.10 (DRIVE), U79.11 (VIN); also elsewhere on the board
+170V: C5.2, C6.2, D1.1 (K), R62.2; also elsewhere on the board
/Nixie_Boost/HV_EN: U79.12 (EN/UVLO); also elsewhere on the board
GND: C1.2, C2.2, C3.2, C4.1, C5.1, C6.1, C7.2, C8.2, R61.2, R63.1, R72.1, T1.1 (PRI_22-72V_KHZ_1), U79.5 (SYNC), U79.6 (*PGOOD), U79.13 (EPAD); also elsewhere on the board
unnamed: C3.1, R65.1
unnamed: D1.2 (A), T1.3 (PRI_22-72V_KHZ_3)
unnamed: Q1.2 (D), T1.4 (SEC_3.3V500MA_1)
unnamed: Q1.1 (G), R64.2
unnamed: Q1.3 (S), R61.1, U79.7 (SENSE)
unnamed: R62.1, R63.2, U79.2 (FBX)
unnamed: R64.1, U79.8 (GATE)
unnamed: C7.1, U79.9 (INTVCC)
unnamed: R72.2, U79.4 (RT)
unnamed: C4.2, U79.3 (SS)
unnamed: R65.2, U79.1 (VC)

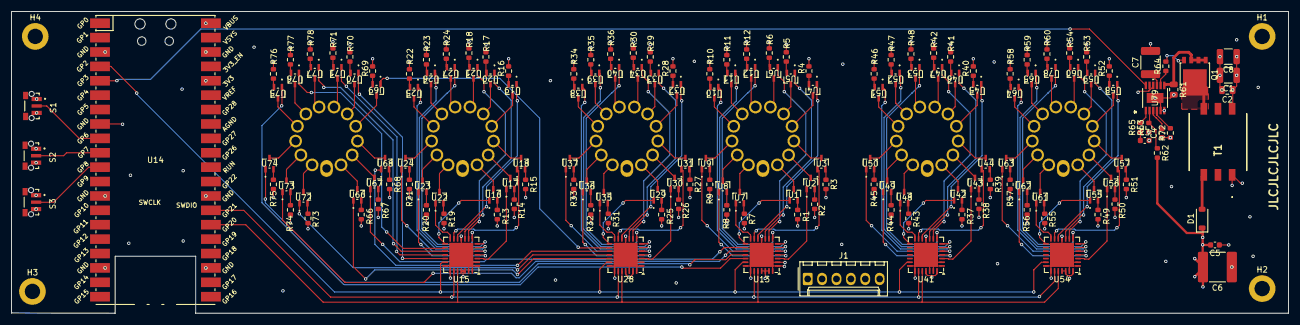
[picture p33: board nixie_clock.kicad_pcb from above]

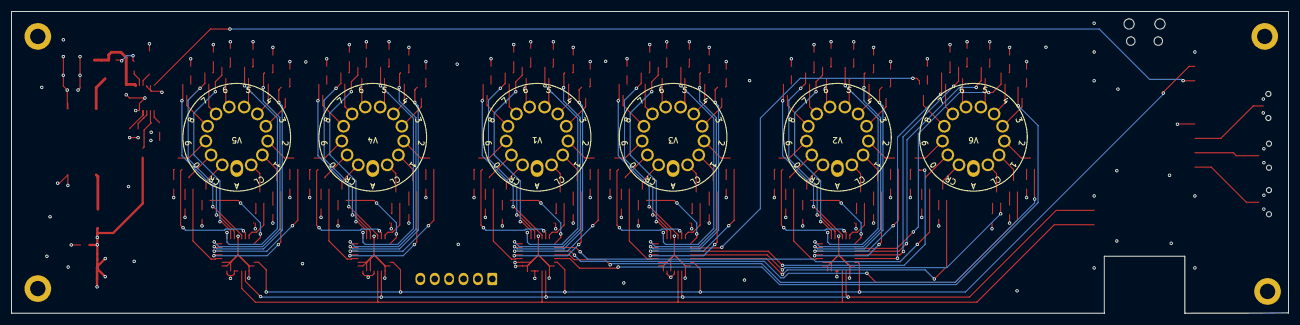
[picture p34: board nixie_clock.kicad_pcb from below]

Board: 6 copper layers, 225.3 x 53.2 mm, 182 parts (6 on the bottom side), 238 nets.
