dalvador2/nixie_clock/pcb/nixie_clock/Nixie_Control.kicad_pcb

## KiCad design pcb/nixie_clock/Nixie_Control.kicad_pcb (2025-02-11)

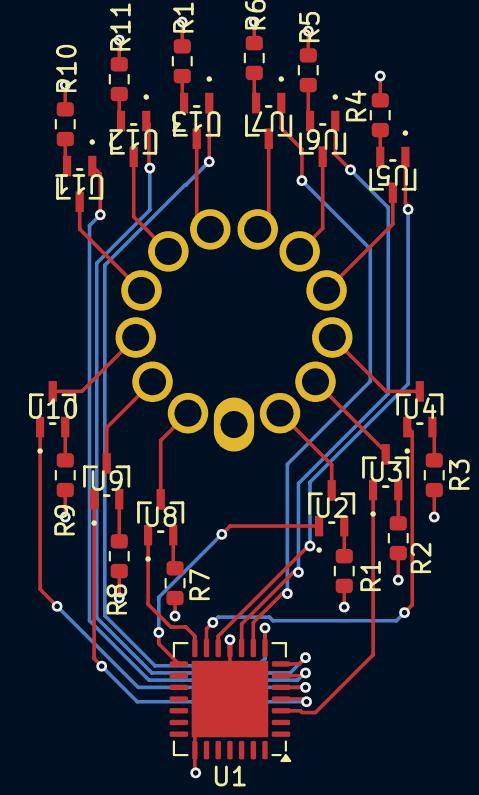
[picture p35: board Nixie_Control.kicad_pcb from above]

Board: 6 copper layers, 26 parts (1 on the bottom side), 37 nets.

Parts:
R1, R7: 7K87; R_0603_1608Metric
R2, R3, R4, R5, R6, R8, R9, R10, R11, R12: 1K; R_0603_1608Metric
U1: PCA9685BS; QFN-28-1EP_6x6mm_P0.65mm_EP4.25x4.25mm
U2, U3, U4, U5, U6, U7, U8, U9, U10, U11, U12, U13: MSD42WT1G; SOT-323-3_2P2X1P35_ONS
V1: IN14

Connections:
/Nixie_Block2/Cath_0: U1.3 (LED0), U9.1 (BASE)
/Nixie_Block2/Cath_1: U1.4 (LED1), U3.1 (BASE)
/Nixie_Block2/Cath_2: U1.5 (LED2), U4.1 (BASE)
/Nixie_Block2/Cath_3: U1.6 (LED3), U5.1 (BASE)
/Nixie_Block2/Cath_4: U1.7 (LED4), U6.1 (BASE)
/Nixie_Block2/Cath_5: U1.8 (LED5), U7.1 (BASE)
/Nixie_Block2/Cath_6: U1.9 (LED6), U13.1 (BASE)
/Nixie_Block2/Cath_7: U1.10 (LED7), U12.1 (BASE)
/Nixie_Block2/Cath_8: U1.12 (LED8), U11.1 (BASE)
/Nixie_Block2/Cath_9: U1.13 (LED9), U10.1 (BASE)
/Nixie_Block2/Comma_L: U1.14 (LED10), U2.1 (BASE)
/Nixie_Block2/Comma_R: U1.15 (LED11), U8.1 (BASE)
GND: R1.2, R2.2, R3.2, R4.2, R5.2, R6.2, R7.2, R8.2, R9.2, R10.2, R11.2, R12.2, U1.11 (VSS), U1.22 (EXTCLK), U1.29 (VSS)
unnamed: U2.3 (COLLECTOR), V1.13 (Comma_L)
unnamed: R1.1, U2.2 (EMITTER)
unnamed: U3.3 (COLLECTOR), V1.12 (Cath_1)
unnamed: R2.1, U3.2 (EMITTER)
unnamed: U4.3 (COLLECTOR), V1.11 (Cath_2)
unnamed: R3.1, U4.2 (EMITTER)
unnamed: U5.3 (COLLECTOR), V1.10 (Cath_3)
unnamed: R4.1, U5.2 (EMITTER)
unnamed: U6.3 (COLLECTOR), V1.9 (Cath_4)
unnamed: R5.1, U6.2 (EMITTER)
unnamed: U7.3 (COLLECTOR), V1.8 (Cath_5)
unnamed: R6.1, U7.2 (EMITTER)
unnamed: U8.3 (COLLECTOR), V1.2 (Comma_R)
unnamed: R7.1, U8.2 (EMITTER)
unnamed: U9.3 (COLLECTOR), V1.3 (Cath_0)
unnamed: R8.1, U9.2 (EMITTER)
unnamed: U10.3 (COLLECTOR), V1.4 (Cath_9)
unnamed: R9.1, U10.2 (EMITTER)
unnamed: U11.3 (COLLECTOR), V1.5 (Cath_8)
unnamed: R10.1, U11.2 (EMITTER)
unnamed: U12.3 (COLLECTOR), V1.6 (Cath_7)
unnamed: R11.1, U12.2 (EMITTER)
unnamed: U13.3 (COLLECTOR), V1.7 (Cath_6)
unnamed: R12.1, U13.2 (EMITTER)
