dalvador2/nixie_clock/(commit log)

2024-09-27 nixie cad add
2024-09-27 initial stages of clock design and parts list creation
    [full_clock.scad, nixie_arm.scad]
2024-10-20 pcb layout nixie tube wiring
    [Nixie_Block.kicad_sch, Nixie_Boost.kicad_sch, Nixie_Control.kicad_sch, Pico_Conn.kicad_sch, nixie_clock.kicad_pcb, nixie_clock.kicad_sch]
2024-10-21 nixie pin changes and more wiring
    [Nixie_Block.kicad_sch, Nixie_Control.kicad_sch, nixie_clock.kicad_pcb]
2024-10-22 remove busses and output stuff
    [Nixie_Block.kicad_sch, Nixie_Control.kicad_sch, Pico_Conn.kicad_sch, nixie_clock.kicad_sch]
2024-10-29 schematic finalisation, footprint assignment and start on placeing components in layout.
    [Nixie_Block.kicad_sch, Nixie_Boost.kicad_sch, Nixie_Control.kicad_sch, Pico_Conn.kicad_sch, nixie_clock.kicad_pcb, nixie_clock.kicad_sch]
2024-11-01 finalization of schematic (might add fuze on 170v supply) looking at pcb routing now. Decided on 6 layers.
    [Nixie_Block.kicad_sch, Nixie_Boost.kicad_sch, Pico_Conn.kicad_sch, nixie_clock.kicad_pcb]
2024-11-02 hierarkical pcb switch and finishing of layout time for final checks need to redo nixie tube layout
    [Nixie_Block.kicad_pcb, Nixie_Block.kicad_sch, Nixie_Boost.kicad_sch, Nixie_Control.kicad_pcb, Nixie_Control.kicad_sch, nixie_clock.kicad_pcb, nixie_clock.kicad_sch]
2024-11-03 3d models done
    [Nixie_Block.kicad_pcb, Nixie_Block.kicad_sch, Nixie_Boost.kicad_sch, Nixie_Control.kicad_pcb, Nixie_Control.kicad_sch, Pico_Conn.kicad_sch, bom.csv, designators.csv]
2024-11-07 fixing some issues.
    [NX-SZP-IN14-00-v01.SLDPRT, NX-SZP-IN14-01-v01.SLDPRT, NX-SZP-IN14-02-v01.SLDPRT, NX-SZP-IN14-03-v01.SLDPRT, NX-SZP-IN14-04-v01.SLDPRT, NX-SZP-IN14-05-v01.SLDPRT, NX-SZP-IN14-06-v01.SLDPRT, NX-SZP-IN14-07-v01.SLDPRT]
2024-11-07 added grounding
    [Nixie_Block.kicad_sch, Nixie_Control.kicad_pcb, Pico_Conn.kicad_sch, designators.csv, nixie_clock.kicad_pcb, nixie_clock.kicad_sch, positions.csv]
2024-11-19 changes and improvements
    [nixie_clock.kicad_pcb]
2024-12-10 final commits before sending to jlc
    [Nixie_Control.kicad_sch, Pico_Conn.kicad_sch, bom.csv, designators.csv, nixie_clock.kicad_pcb, nixie_clock.kicad_sch, positions.csv]
2025-01-02 pcb final changes or lock files
    [nixie_clock.kicad_pcb]
2025-02-11 pcb changes and breakages need to fix later
    [Nixie_Block.kicad_pcb, Nixie_Block.kicad_sch, Nixie_Control.kicad_pcb, Nixie_Control.kicad_sch, nixie_clock.kicad_sch]
2025-03-11 now communicating
    [nixie_clock.kicad_pcb]
2025-03-24 fix pcb to correct and first steps on a menu
    [nixie_clock.kicad_pcb]
2025-03-24 updated to kicad9
    [Nixie_Block.kicad_sch, Nixie_Boost.kicad_sch, Nixie_Control.kicad_sch, Pico_Conn.kicad_sch, nixie_clock.kicad_pcb, nixie_clock.kicad_sch]
